hsetlik/PhaserPedal/PhaserPedalBoard/PhaserPedalBoard.kicad_pcb

## KiCad design PhaserPedalBoard/PhaserPedalBoard.kicad_pcb (2026-10-17)

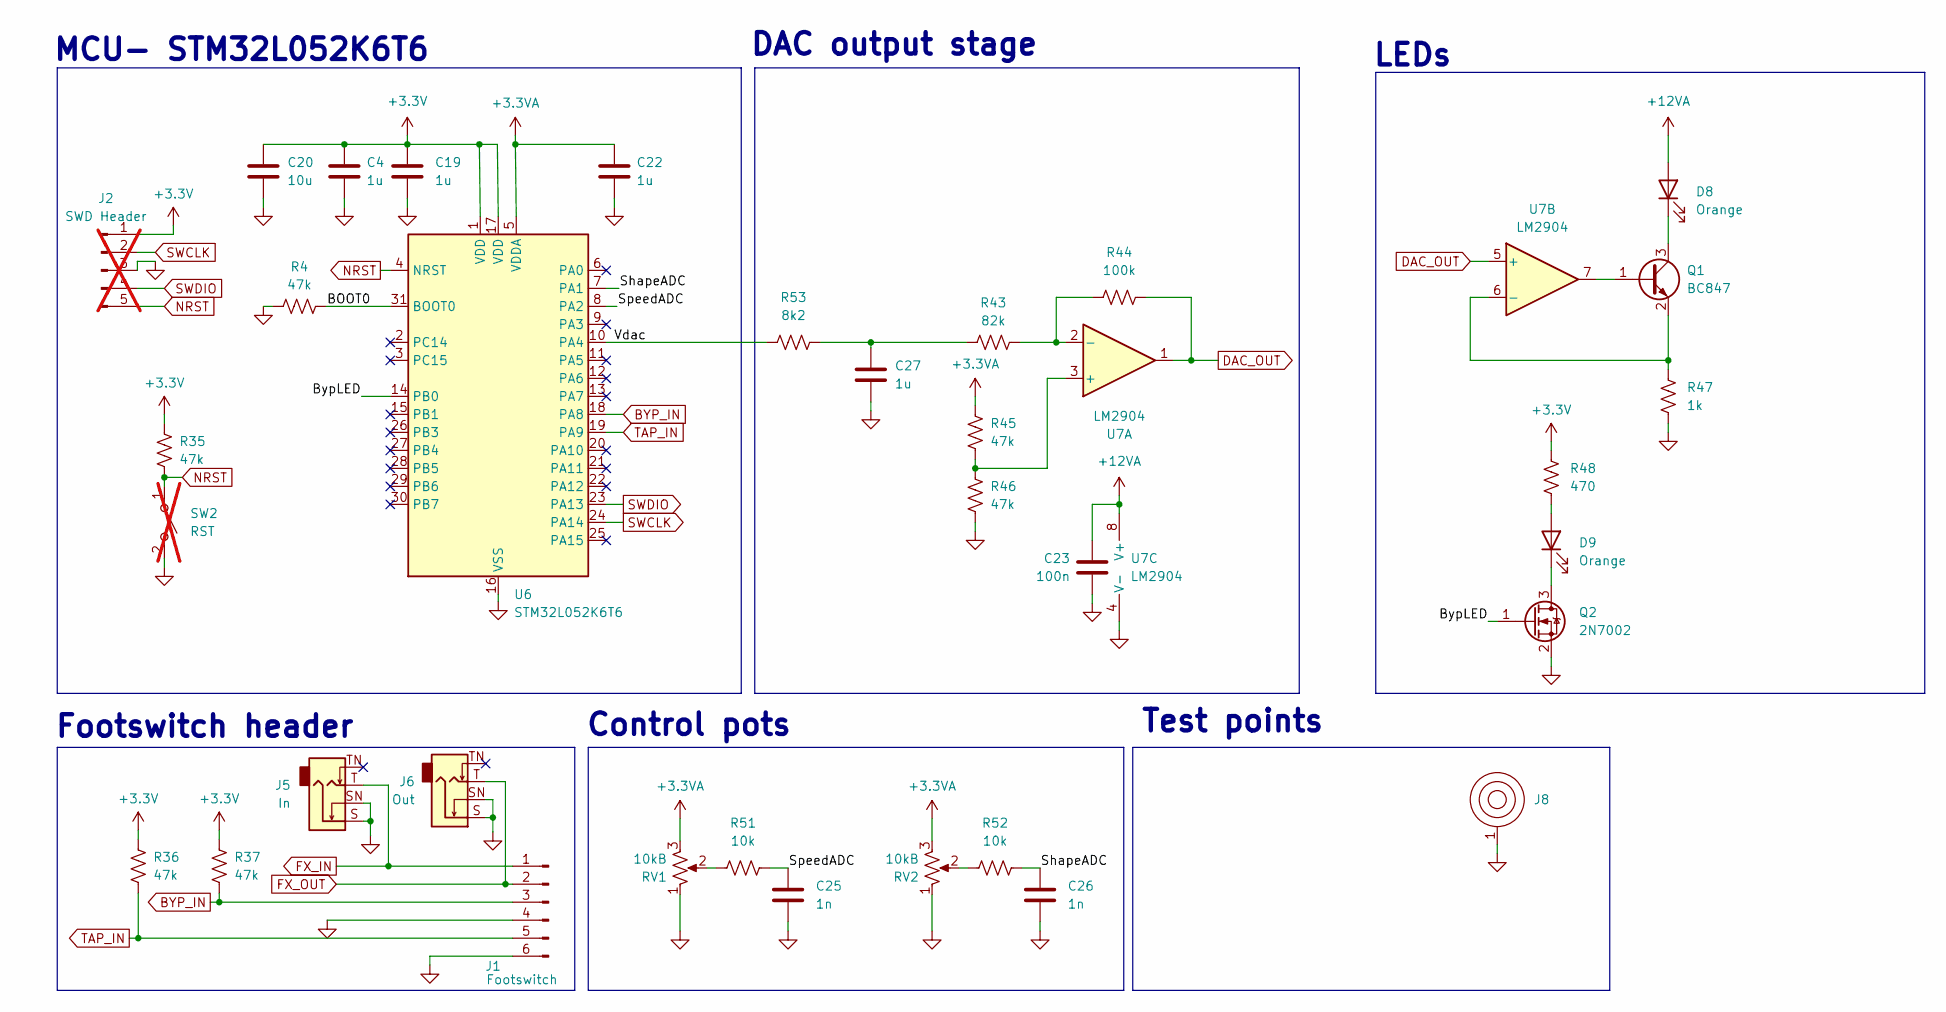
[picture p6: schematic Digital.kicad_sch]

Parts:
C4, C19, C22, C27: 1u; C_0805_2012Metric
C20: 10u; C_0805_2012Metric
C23: 100n; C_0805_2012Metric
C25, C26: 1n; C_0805_2012Metric
D8, D9: Orange; LED_D3.0mm; MPN LTL-4291N
J1: Footswitch; PinHeader_1x06_P2.54mm_Vertical
J2: SWD Header; PinHeader_1x05_P2.54mm_Vertical; not fitted
J5: In; Jack_6.35mm_Tayda_PJ664C_Mono_Horizontal; MPN PJ-644C MONO
J6: Out; Jack_6.35mm_Tayda_PJ664C_Mono_Horizontal; MPN PJ-644C MONO
J8: BatteryContact_Keystone_243
Q1: BC847; SOT-23
Q2: 2N7002; SOT-23; MPN 2N7002NXAKR
R4, R45, R46: 47k; R_0805_2012Metric
R35, R36, R37: 47k; R_0805_2012Metric; MPN RK73B2ATTE473J
R43: 82k; R_0805_2012Metric
R44: 100k; R_0805_2012Metric
R47: 1k; R_0805_2012Metric
R48: 470; R_0805_2012Metric; MPN RC0805JR-10470RL
R51, R52: 10k; R_0805_2012Metric
R53: 8k2; R_0805_2012Metric
RV1, RV2: 10kB; Potentiometer_Alpha_RV16AF_42_Single_Long; MPN RV9022NO-PA30B7.0-B10K-000-W3.0
SW2: RST; SW_SPST_B3U-1000P; not fitted
U6: STM32L052K6T6; LQFP-32_7x7mm_P0.8mm
U7: LM2904; SOIC-8_3.9x4.9mm_P1.27mm

Connections:
+3.3V: C4.1, C19.1, C20.1, J2.1, R35.1, R36.1, R37.1, R48.1, U6.1 (VDD), U6.17 (VDD); also elsewhere on the board
+3.3VA: C22.1, R45.2, RV1.3, RV2.3, U6.5 (VDDA); also elsewhere on the board
+12VA: C23.1, D8.2 (A), U7.8 (V+); also elsewhere on the board
/Digital/BOOT0: R4.2, U6.31 (BOOT0)
/Digital/BypLED: Q2.1 (G), U6.14 (PB0)
/Digital/ShapeADC: C26.1, R52.2, U6.7 (PA1)
/Digital/SpeedADC: C25.1, R51.2, U6.8 (PA2)
/Digital/Vdac: R53.1, U6.10 (PA4)
BYP_IN: J1.3, R37.2, U6.18 (PA8)
DAC_OUT: R44.2, U7.1, U7.5 (+); also elsewhere on the board
FX_IN: J1.1, J5.T; also elsewhere on the board
FX_OUT: J1.2, J6.T; also elsewhere on the board
GND: C4.2, C19.2, C20.2, C22.2, C23.2, C25.2, C26.2, C27.2, J1.4, J1.6, J2.3, J5.S, J5.SN, J6.S, J6.SN, J8.1, Q2.2 (S), R4.1, R46.1, R47.1, RV1.1, RV2.1, SW2.2 (B), U6.16 (VSS), U6.32 (VSS), U7.4 (V-); also elsewhere on the board
NRST: J2.5, R35.2, SW2.1 (A), U6.4 (NRST)
unnamed: C27.1, R43.1, R53.2
unnamed: D8.1 (K), Q1.3 (C)
unnamed: D9.2 (A), R48.2
unnamed: D9.1 (K), Q2.3 (D)
unnamed: Q1.1 (B), U7.7
unnamed: Q1.2 (E), R47.2, U7.6 (-)
unnamed: R51.1, RV1.2
unnamed: R52.1, RV2.2
unnamed: R45.1, R46.2, U7.3 (+)
unnamed: R43.2, R44.1, U7.2 (-)
SWCLK: J2.2, U6.24 (PA14)
SWDIO: J2.4, U6.23 (PA13)
TAP_IN: J1.5, R36.2, U6.19 (PA9)

Notes on the sheet:
Test points
MCU- STM32L052K6T6
LEDs
Footswitch header
Control pots
DAC output stage

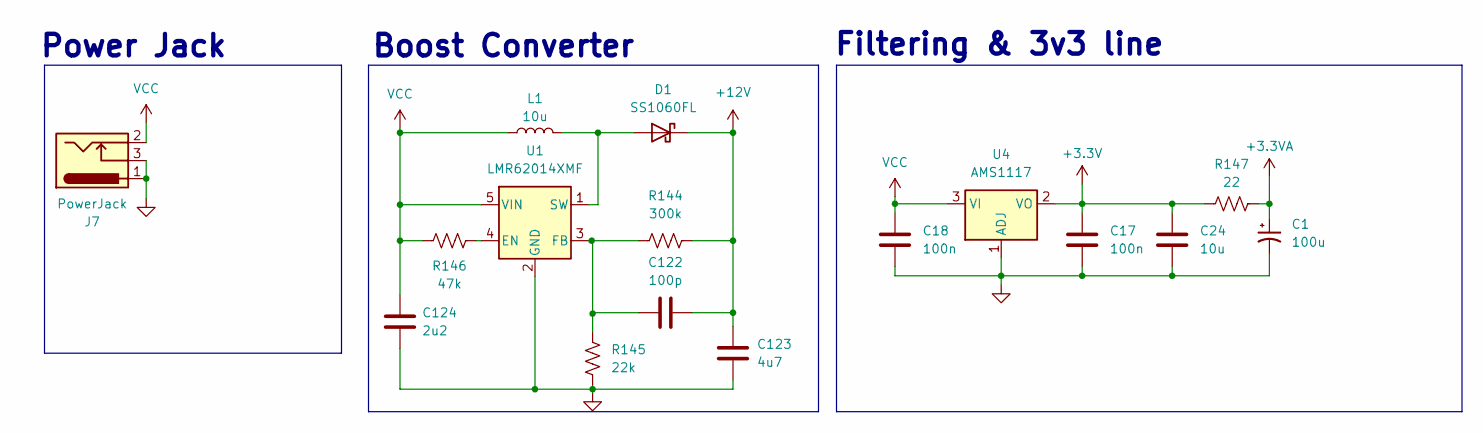
[picture p7: schematic Power.kicad_sch]

Parts:
C1: 100u; CP_Radial_D6.3mm_P2.50mm
C17, C18: 100n; C_0805_2012Metric; MPN KGF21BR71H104KT
C24: 10u; C_0805_2012Metric; MPN KGM21AR50J106KU
C122: 100p; C_0805_2012Metric
C123: 4u7; C_0805_2012Metric
C124: 2u2; C_0805_2012Metric
D1: SS1060FL; D_SOD-123F
J7: PowerJack; BarrelJack_Horizontal; MPN NEB 21 R-C
L1: 10u; L_SigTransformer_SLPPI04_15
R144: 300k; R_0805_2012Metric
R145: 22k; R_0805_2012Metric
R146: 47k; R_0805_2012Metric
R147: 22; R_0805_2012Metric
U1: LMR62014XMF; SOT-23-5
U4: AMS1117; SOT-223-3_TabPin2; MPN LD1117S33CTR

Connections:
+3.3V: C17.2, C24.2, R147.2, U4.2 (VO); also elsewhere on the board
+3.3VA: C1.1, R147.1; also elsewhere on the board
+12V: C122.2, C123.1, D1.1 (K), R144.2; also elsewhere on the board
GND: C1.2, C17.1, C18.1, C24.1, C123.2, C124.2, J7.1, J7.3, R145.1, U1.2 (GND), U4.1 (ADJ); also elsewhere on the board
unnamed: D1.2 (A), L1.2, U1.1 (SW)
unnamed: R146.2, U1.4 (EN)
unnamed: C122.1, R144.1, R145.2, U1.3 (FB)
VCC: C18.2, C124.1, J7.2, L1.1, R146.1, U1.5 (VIN), U4.3 (VI)

Notes on the sheet:
Power Jack
Filtering & 3v3 line
Boost Converter

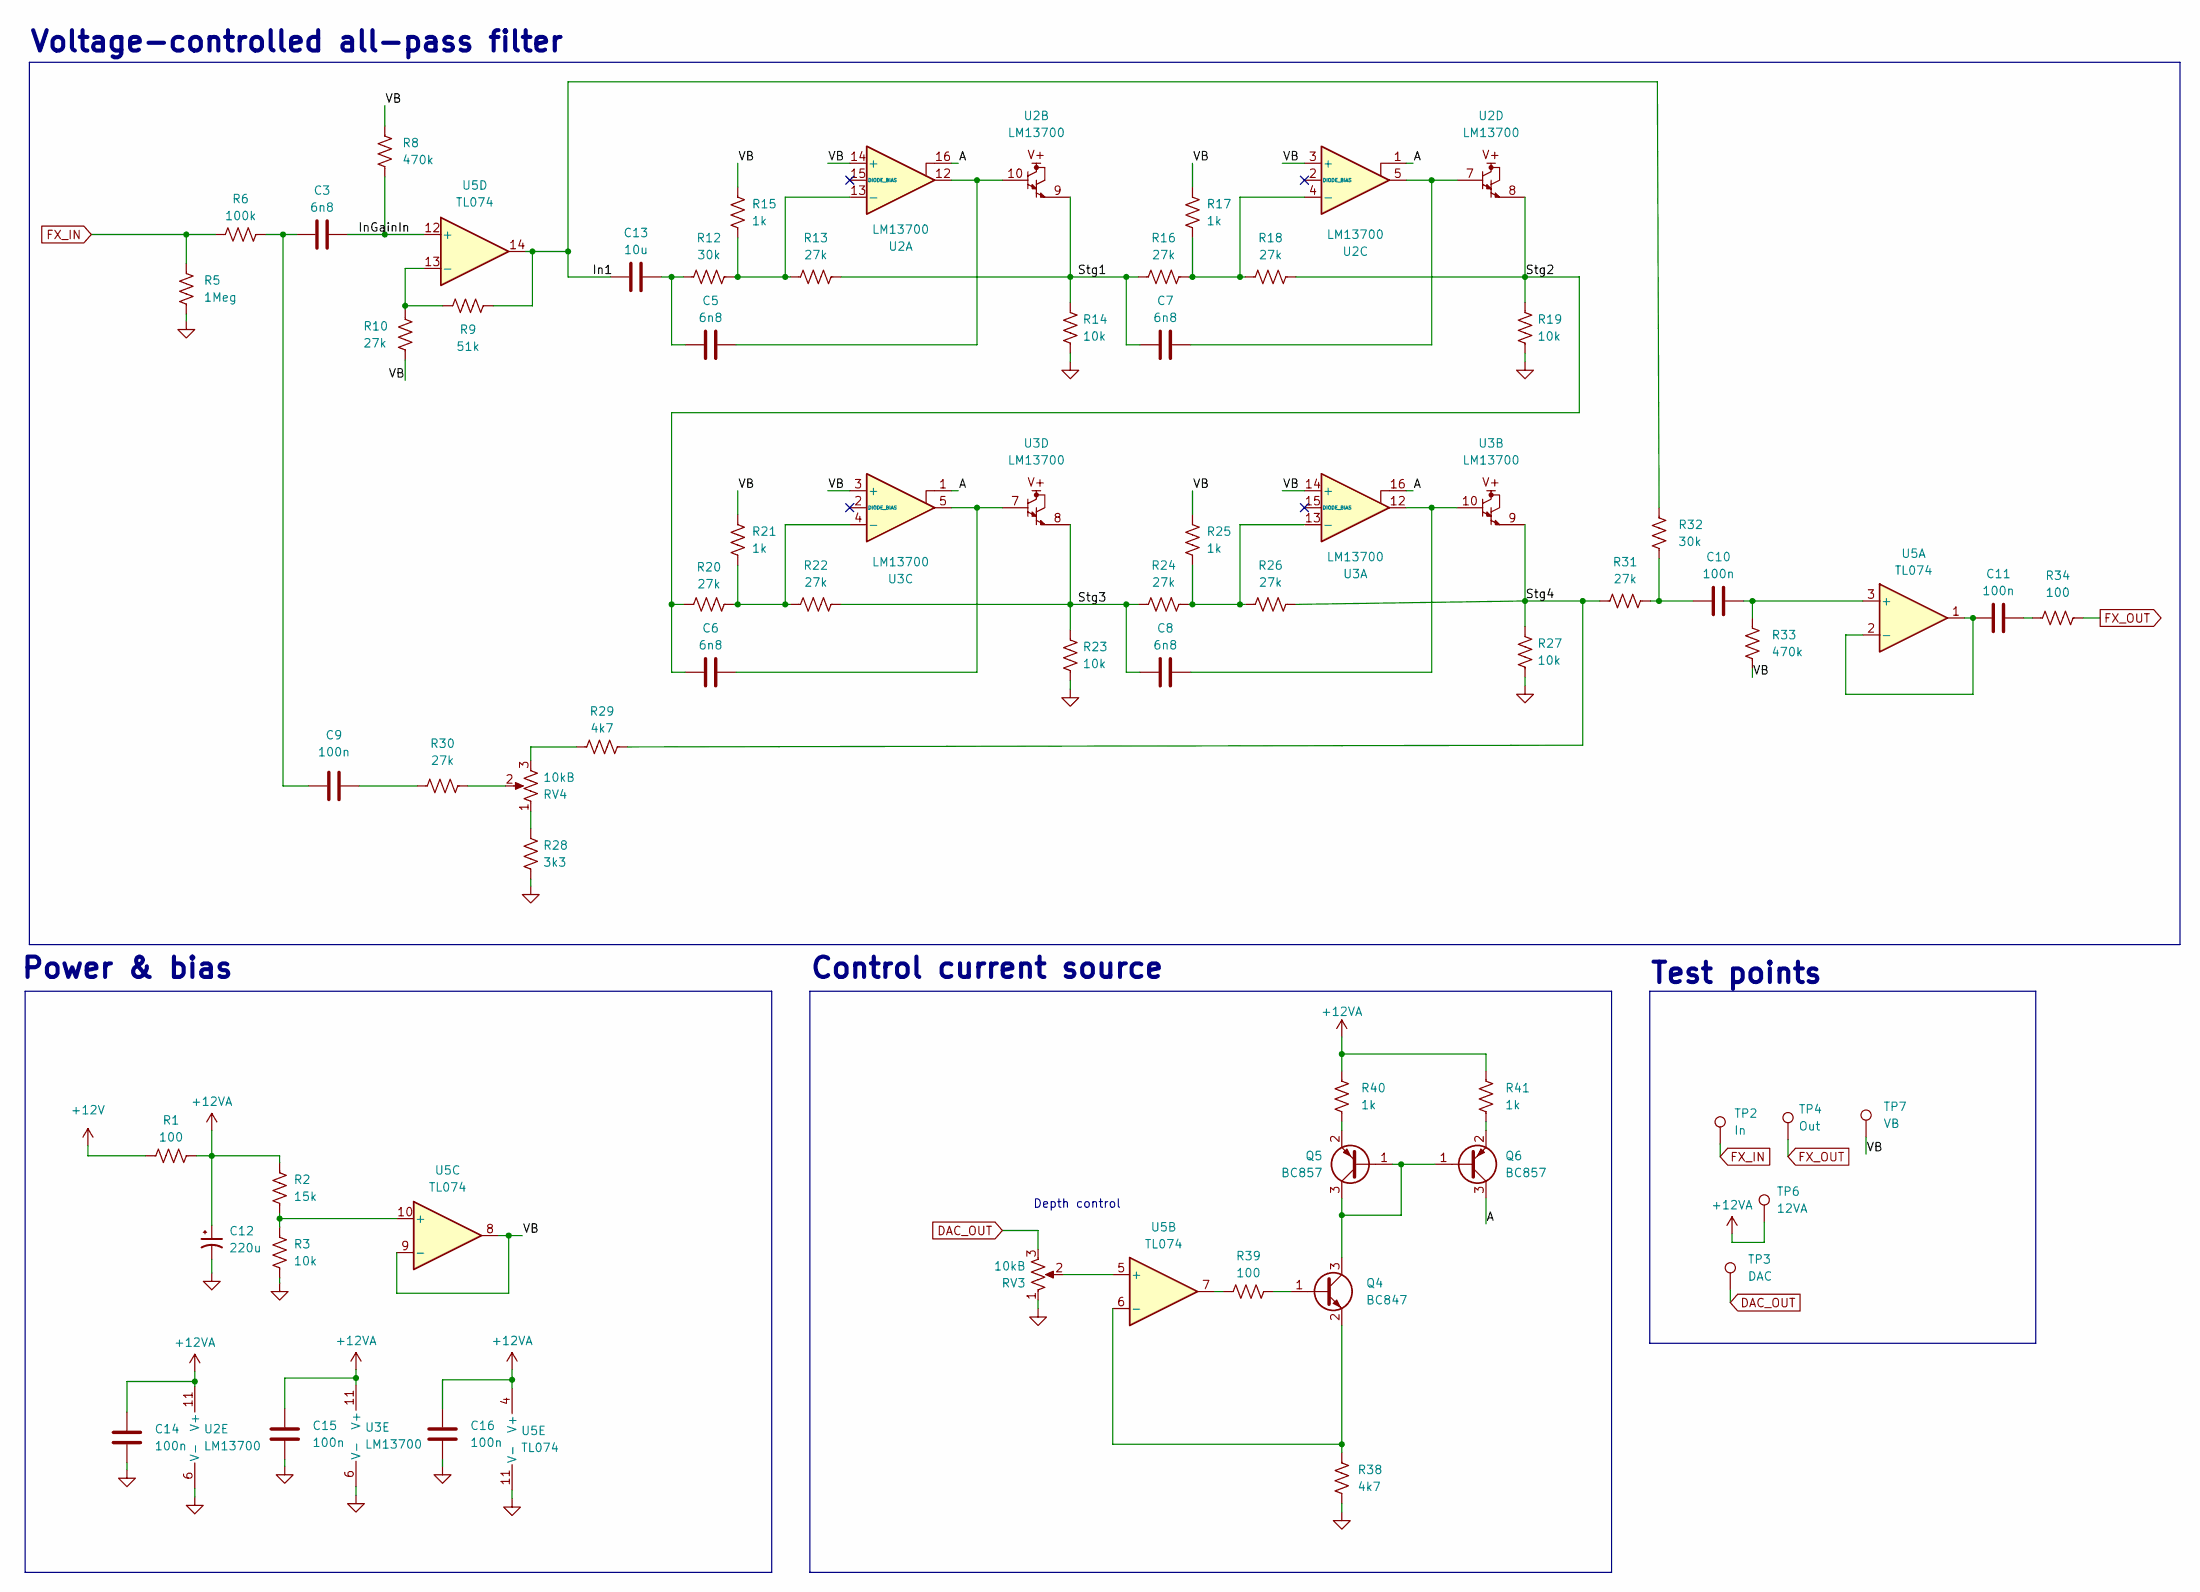
[picture p8: schematic Analog.kicad_sch]

Parts:
C3, C5, C6, C7, C8: 6n8; C_0805_2012Metric
C9, C10, C11, C14, C15, C16: 100n; C_0805_2012Metric
C12: 220u; CP_Radial_D7.5mm_P2.50mm
C13: 10u; C_0805_2012Metric
Q4: BC847; SOT-23
Q5, Q6: BC857; SOT-23
R1, R34, R39: 100; R_0805_2012Metric
R2: 15k; R_0805_2012Metric
R3, R14, R19, R23, R27: 10k; R_0805_2012Metric
R5: 1Meg; R_0805_2012Metric
R6: 100k; R_0805_2012Metric
R8, R33: 470k; R_0805_2012Metric
R9: 51k; R_0805_2012Metric
R10, R13, R16, R18, R20, R22, R24, R26, R30, R31: 27k; R_0805_2012Metric
R12, R32: 30k; R_0805_2012Metric
R15, R17, R21, R25, R40, R41: 1k; R_0805_2012Metric
R28: 3k3; R_0805_2012Metric
R29, R38: 4k7; R_0805_2012Metric
RV3, RV4: 10kB; Potentiometer_Alpha_RV16AF_42_Single_Long; MPN RV9022NO-PA30B7.0-B10K-000-W3.0
TP2: In; TestPoint_THTPad_D2.0mm_Drill1.0mm_VAL
TP3: DAC; TestPoint_THTPad_D2.0mm_Drill1.0mm_VAL
TP4: Out; TestPoint_THTPad_D2.0mm_Drill1.0mm_VAL
TP6: 12VA; TestPoint_THTPad_D2.0mm_Drill1.0mm_VAL
TP7: VB; TestPoint_THTPad_D2.0mm_Drill1.0mm_VAL
U2, U3: LM13700; SOIC-16_3.9x9.9mm_P1.27mm
U5: TL074; SOIC-14_3.9x8.7mm_P1.27mm

Connections:
+12V: R1.1; also elsewhere on the board
+12VA: C12.1, C14.2, C15.2, C16.2, R1.2, R2.2, R40.2, R41.2, TP6.1 (1_1), U2.11 (V+), U3.11 (V+), U5.4 (V+); also elsewhere on the board
/Analog/A: Q6.3 (C), U2.1, U2.16, U3.1, U3.16
/Analog/In1: C13.1, R9.1, R32.1, U5.14
/Analog/InGainIn: C3.2, R8.1, U5.12 (+)
/Analog/Stg1: C7.1, R13.1, R14.1, R16.2, U2.9
/Analog/Stg2: C6.1, R18.1, R19.1, R20.2, U2.8
/Analog/Stg3: C8.1, R22.1, R23.1, R24.2, U3.8
/Analog/Stg4: R26.1, R27.1, R29.2, R31.2, U3.9
/Analog/VB: R8.2, R10.2, R15.1, R17.1, R21.1, R25.1, R33.2, TP7.1 (1_1), U2.3 (+), U2.14 (+), U3.3 (+), U3.14 (+), U5.8, U5.9 (-)
DAC_OUT: RV3.3, TP3.1 (1_1); also elsewhere on the board
FX_IN: R5.2, R6.1, TP2.1 (1_1); also elsewhere on the board
FX_OUT: R34.1, TP4.1 (1_1); also elsewhere on the board
GND: C12.2, C14.1, C15.1, C16.1, R3.1, R5.1, R14.2, R19.2, R23.2, R27.2, R28.1, R38.1, RV3.1, U2.6 (V-), U3.6 (V-), U5.11 (V-); also elsewhere on the board
unnamed: C3.1, C9.1, R6.2
unnamed: C5.2, U2.10, U2.12
unnamed: C6.2, U3.5, U3.7
unnamed: C7.2, U2.5, U2.7
unnamed: C8.2, U3.10, U3.12
unnamed: C9.2, R30.1
unnamed: C10.1, R31.1, R32.2
unnamed: C11.2, R34.2
unnamed: C5.1, C13.2, R12.2
unnamed: Q4.1 (B), R39.2
unnamed: Q4.3 (C), Q5.1 (B), Q5.3 (C), Q6.1 (B)
unnamed: Q4.2 (E), R38.2, U5.6 (-)
unnamed: Q5.2 (E), R40.1
unnamed: Q6.2 (E), R41.1
unnamed: R28.2, RV4.1
unnamed: R29.1, RV4.3
unnamed: R30.2, RV4.2
unnamed: R39.1, U5.7
unnamed: R12.1, R13.2, R15.2, U2.13 (-)
unnamed: R16.1, R17.2, R18.2, U2.4 (-)
unnamed: R24.1, R25.2, R26.2, U3.13 (-)
unnamed: R20.1, R21.2, R22.2, U3.4 (-)
unnamed: C10.2, R33.1, U5.3 (+)
unnamed: C11.1, U5.1, U5.2 (-)
unnamed: RV3.2, U5.5 (+)
unnamed: R2.1, R3.2, U5.10 (+)
unnamed: R9.2, R10.1, U5.13 (-)

Notes on the sheet:
Control current source
Test points
Voltage-controlled all-pass filter
Depth control
Power & bias

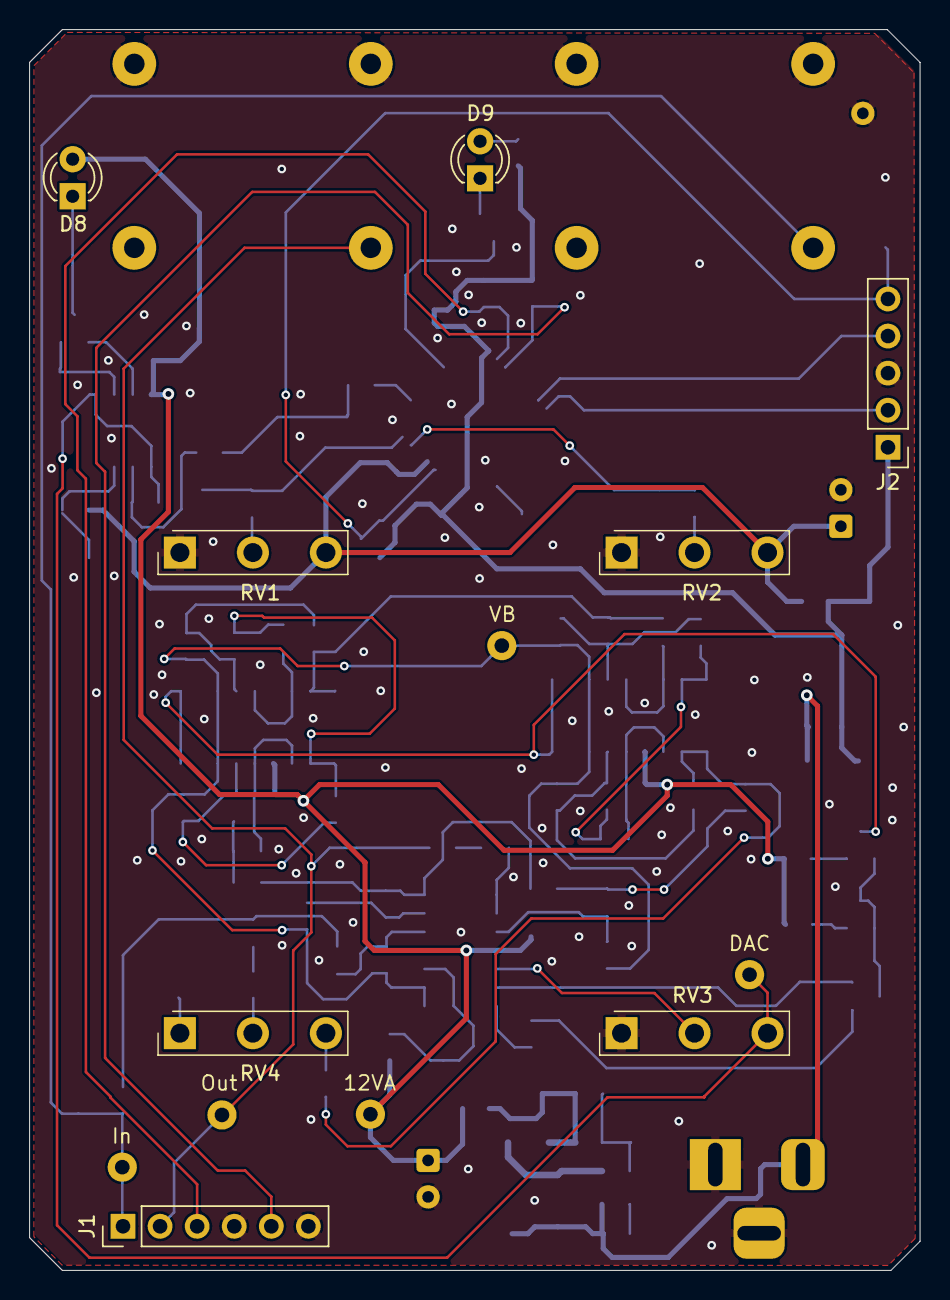
[picture p9: board PhaserPedalBoard.kicad_pcb from above]

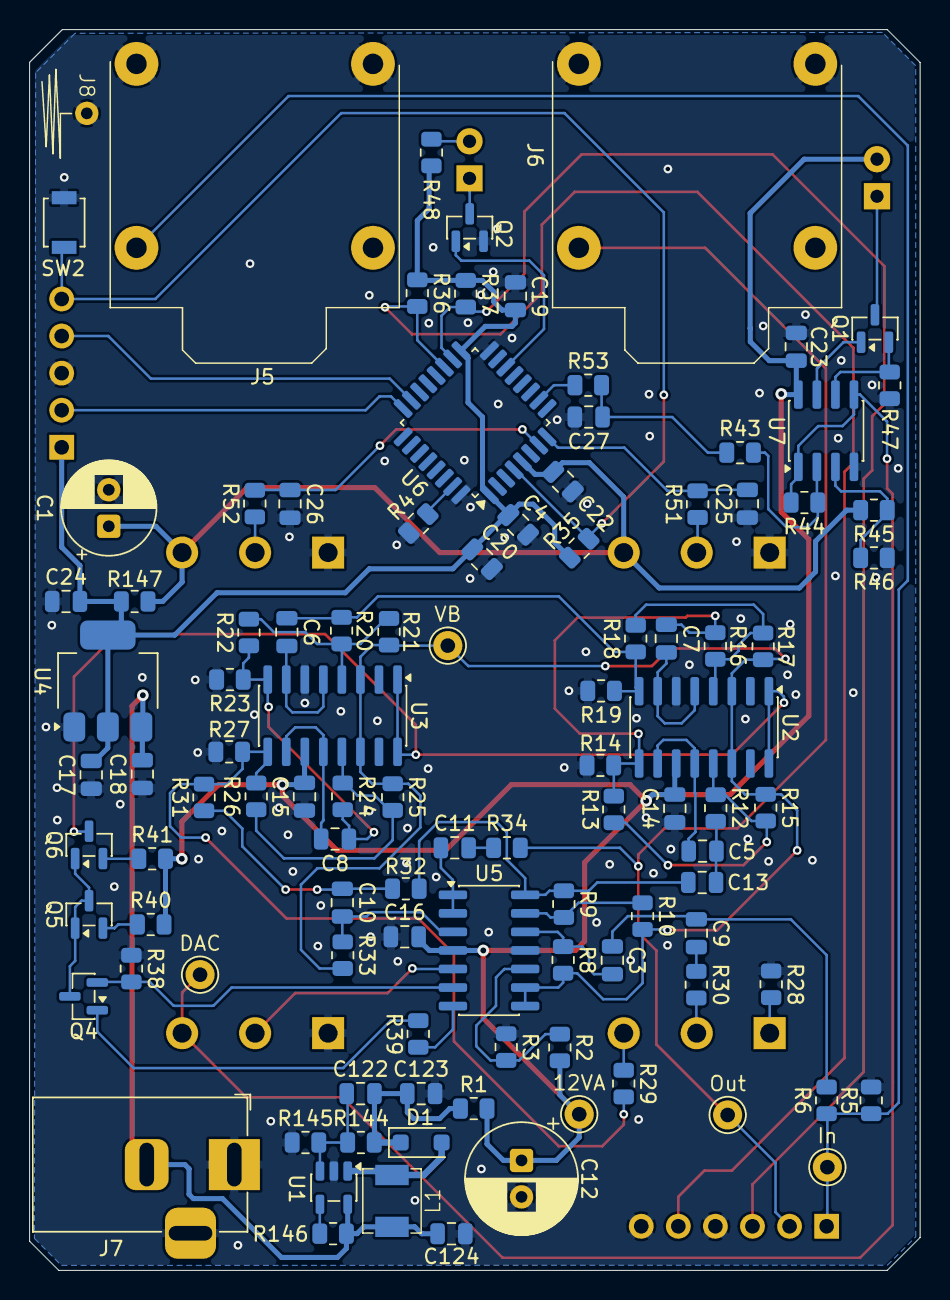
[picture p10: board PhaserPedalBoard.kicad_pcb from below]

Board: 4 copper layers, 61.0 x 85.0 mm, 112 parts (104 on the bottom side), 67 nets.
