hsetlik/PhaserPedal/Simulations/AnalogSim/AnalogSim.kicad_sch

## KiCad design Simulations/AnalogSim/AnalogSim.kicad_sch (2026-10-16)

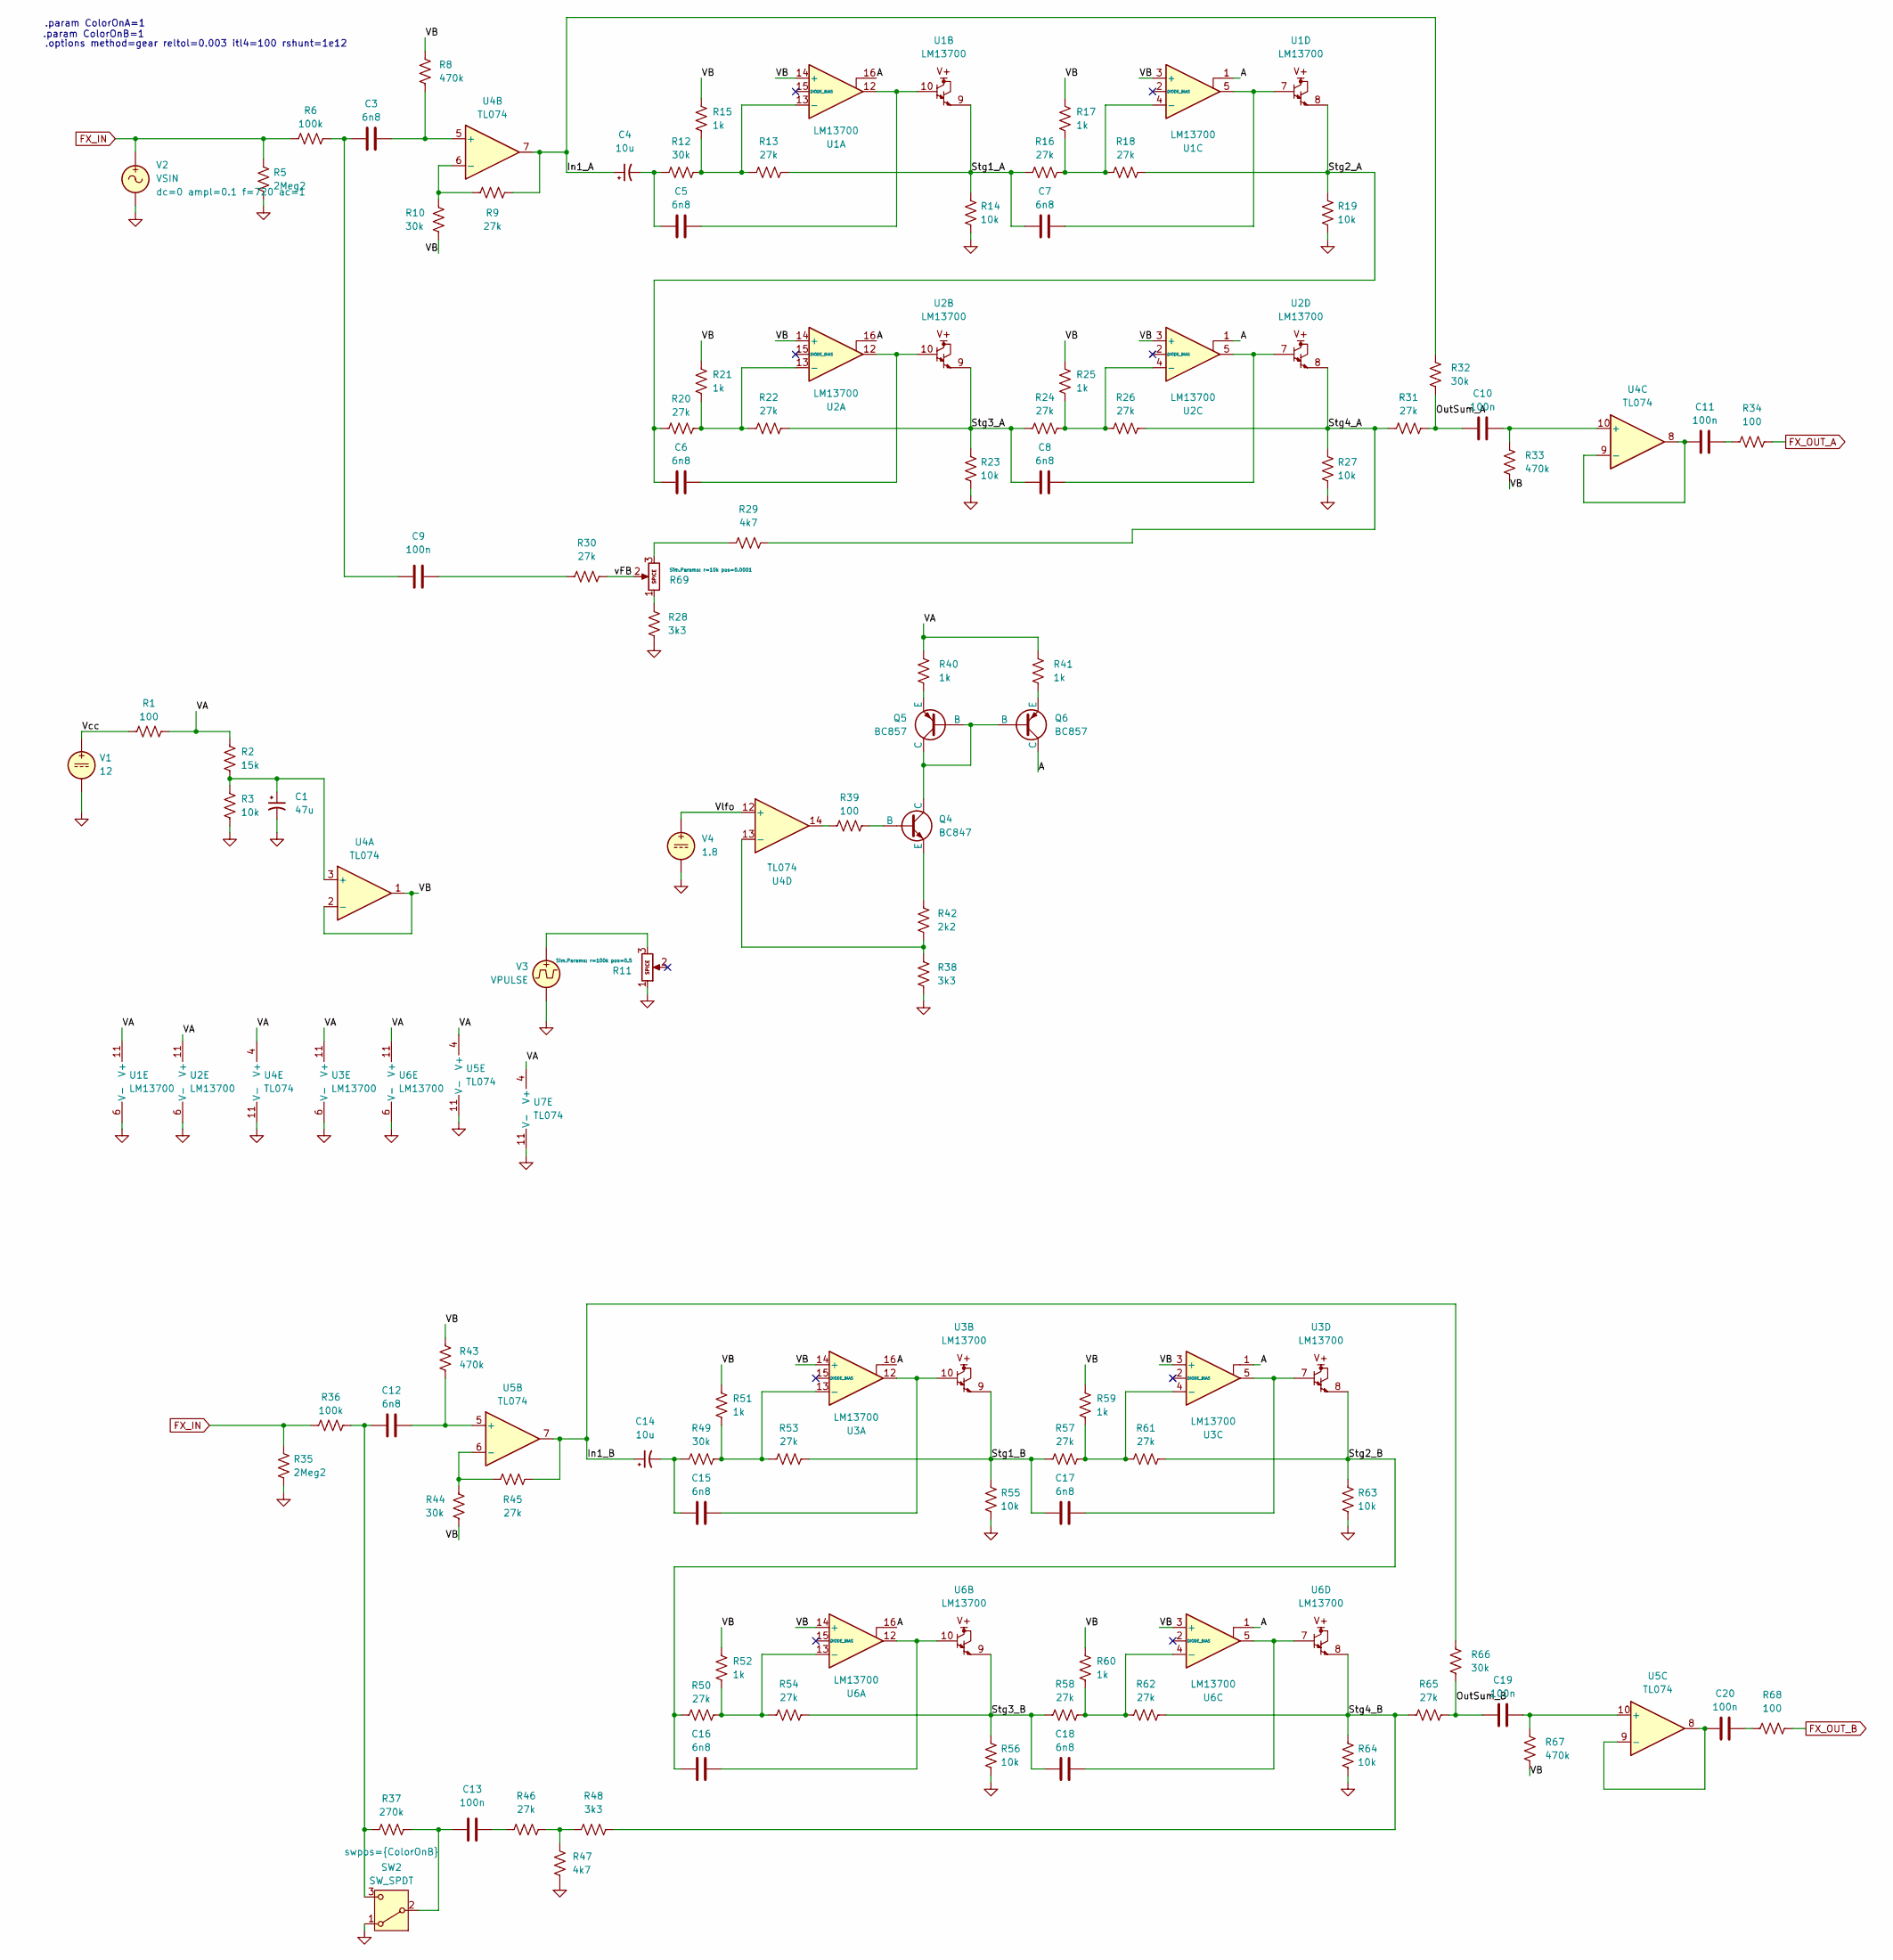
[picture p11: schematic AnalogSim.kicad_sch]

Parts:
C1: 47u
C3, C5, C6, C7, C8, C12, C15, C16, C17, C18: 6n8
C4, C14: 10u
C9, C10, C11, C13, C19, C20: 100n
Q4: BC847
Q5, Q6: BC857
R1, R34, R39, R68: 100
R2: 15k
R3, R14, R19, R23, R27, R55, R56, R63, R64: 10k
R5, R35: 2Meg2
R6, R36: 100k
R8, R33, R43, R67: 470k
R9, R13, R16, R18, R20, R22, R24, R26, R30, R31, R45, R46, R50, R53, R54, R57, R58, R61, R62, R65: 27k
R10, R12, R32, R44, R49, R66: 30k
R11, R69: Potentiometer
R15, R17, R21, R25, R40, R41, R51, R52, R59, R60: 1k
R28, R38, R48: 3k3
R29, R47: 4k7
R37: 270k
R42: 2k2
SW2: SW_SPDT; SW_SPDT_Dailywell_Mini_1M
U1, U2, U3, U6: LM13700
U4, U5, U7: TL074; SOIC-14_3.9x8.7mm_P1.27mm
V1: 12
V2: VSIN
V3: VPULSE
V4: 1.8

Connections:
A: Q6.1 (C), U1.1, U1.16, U2.1, U2.16, U3.1, U3.16, U6.1, U6.16
FX_IN: R5.2, R6.1, R35.2, R36.1, V2.1
FX_OUT_A: R34.1
FX_OUT_B: R68.1
GND: C1.2, R3.1, R5.1, R11.1, R14.2, R19.2, R23.2, R27.2, R28.1, R35.1, R38.1, R47.1, R55.2, R56.2, R63.2, R64.2, SW2.1 (A), U1.6 (V-), U2.6 (V-), U3.6 (V-), U4.11 (V-), U5.11 (V-), U6.6 (V-), U7.11 (V-), V1.2, V2.2, V3.2, V4.2
In1_A: C4.1, R9.1, R32.1, U4.7
In1_B: C14.1, R45.1, R66.1, U5.7
unnamed: C1.1, R2.1, R3.2, U4.3 (+)
unnamed: C3.1, C9.1, R6.2
unnamed: C3.2, R8.1, U4.5 (+)
unnamed: C4.2, C5.1, R12.2
unnamed: C5.2, U1.10, U1.12
unnamed: C6.2, U2.10, U2.12
unnamed: C7.2, U1.5, U1.7
unnamed: C8.2, U2.5, U2.7
unnamed: C9.2, R30.1
unnamed: C10.2, R33.1, U4.10 (+)
unnamed: C11.1, U4.8, U4.9 (-)
unnamed: C11.2, R34.2
unnamed: C12.1, R36.2, R37.2, SW2.3 (C)
unnamed: C12.2, R43.1, U5.5 (+)
unnamed: C13.1, R37.1, SW2.2 (B)
unnamed: C13.2, R46.1
unnamed: C14.2, C15.1, R49.2
unnamed: C15.2, U3.10, U3.12
unnamed: C16.2, U6.10, U6.12
unnamed: C17.2, U3.5, U3.7
unnamed: C18.2, U6.5, U6.7
unnamed: C19.2, R67.1, U5.10 (+)
unnamed: C20.1, U5.8, U5.9 (-)
unnamed: C20.2, R68.2
unnamed: Q4.1 (C), Q5.1 (C), Q5.2 (B), Q6.2 (B)
unnamed: Q4.2 (B), R39.2
unnamed: Q4.3 (E), R42.2
unnamed: Q5.3 (E), R40.1
unnamed: Q6.3 (E), R41.1
unnamed: R9.2, R10.1, U4.6 (-)
unnamed: R11.3, V3.1
unnamed: R12.1, R13.2, R15.2, U1.13 (-)
unnamed: R16.1, R17.2, R18.2, U1.4 (-)
unnamed: R20.1, R21.2, R22.2, U2.13 (-)
unnamed: R24.1, R25.2, R26.2, U2.4 (-)
unnamed: R28.2, R69.1
unnamed: R29.1, R69.3
unnamed: R38.2, R42.1, U4.13 (-)
unnamed: R39.1, U4.14
unnamed: R44.1, R45.2, U5.6 (-)
unnamed: R46.2, R47.2, R48.1
unnamed: R49.1, R51.2, R53.2, U3.13 (-)
unnamed: R50.1, R52.2, R54.2, U6.13 (-)
unnamed: R57.1, R59.2, R61.2, U3.4 (-)
unnamed: R58.1, R60.2, R62.2, U6.4 (-)
OutSum_A: C10.1, R31.1, R32.2
OutSum_B: C19.1, R65.1, R66.2
Stg1_A: C7.1, R13.1, R14.1, R16.2, U1.9
Stg1_B: C17.1, R53.1, R55.1, R57.2, U3.9
Stg2_A: C6.1, R18.1, R19.1, R20.2, U1.8
Stg2_B: C16.1, R50.2, R61.1, R63.1, U3.8
Stg3_A: C8.1, R22.1, R23.1, R24.2, U2.9
Stg3_B: C18.1, R54.1, R56.1, R58.2, U6.9
Stg4_A: R26.1, R27.1, R29.2, R31.2, U2.8
Stg4_B: R48.2, R62.1, R64.1, R65.2, U6.8
VA: R1.2, R2.2, R40.2, R41.2, U1.11 (V+), U2.11 (V+), U3.11 (V+), U4.4 (V+), U5.4 (V+), U6.11 (V+), U7.4 (V+)
VB: R8.2, R10.2, R15.1, R17.1, R21.1, R25.1, R33.2, R43.2, R44.2, R51.1, R52.1, R59.1, R60.1, R67.2, U1.3 (+), U1.14 (+), U2.3 (+), U2.14 (+), U3.3 (+), U3.14 (+), U4.1, U4.2 (-), U6.3 (+), U6.14 (+)
Vcc: R1.1, V1.1
Vlfo: U4.12 (+), V4.1
vFB: R30.2, R69.2

Notes on the sheet:
.options method=gear reltol=0.003 itl4=100 rshunt=1e12
.param ColorOnA=1
.param ColorOnB=1
