hsetlik/PhaserPedal/Simulations/OutputStageSim/OutputStageSim.kicad_sch

## KiCad design Simulations/OutputStageSim/OutputStageSim.kicad_sch (2026-10-12)

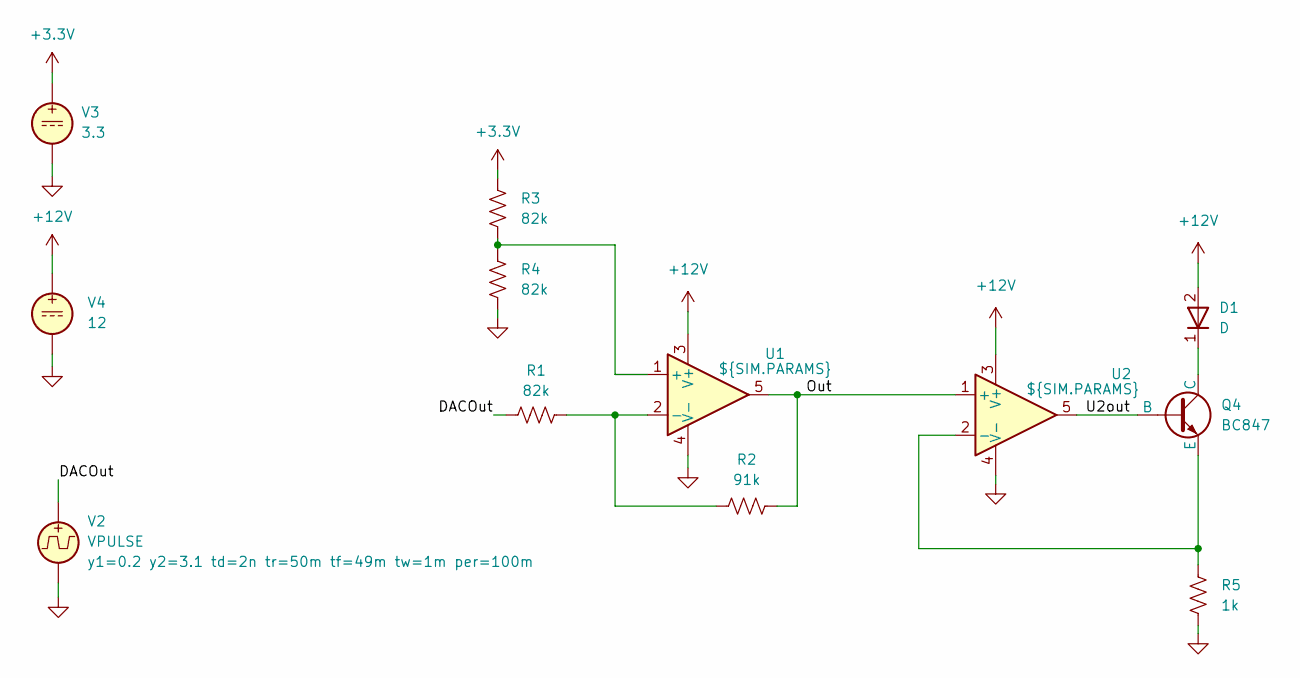
[picture p12: schematic OutputStageSim.kicad_sch]

Parts:
D1: D
Q4: BC847
R1, R3, R4: 82k
R2: 91k
R5: 1k
U1, U2: ${SIM.PARAMS}
V2: VPULSE
V3: 3.3
V4: 12

Connections:
+3.3V: R3.2, V3.1
+12V: D1.2 (A), U1.3 (V+), U2.3 (V+), V4.1
DACOut: R1.1, V2.1
GND: R4.1, R5.1, U1.4 (V-), U2.4 (V-), V2.2, V3.2, V4.2
unnamed: D1.1 (K), Q4.1 (C)
unnamed: Q4.3 (E), R5.2, U2.2 (-)
unnamed: R1.2, R2.1, U1.2 (-)
unnamed: R3.1, R4.2, U1.1 (+)
Out: R2.2, U1.5, U2.1 (+)
U2out: Q4.2 (B), U2.5
