hsetlik/PhaserPedal/Simulations/SmallStoneSim/SmallStoneSim.kicad_sch

## KiCad design Simulations/SmallStoneSim/SmallStoneSim.kicad_sch (2026-10-11)

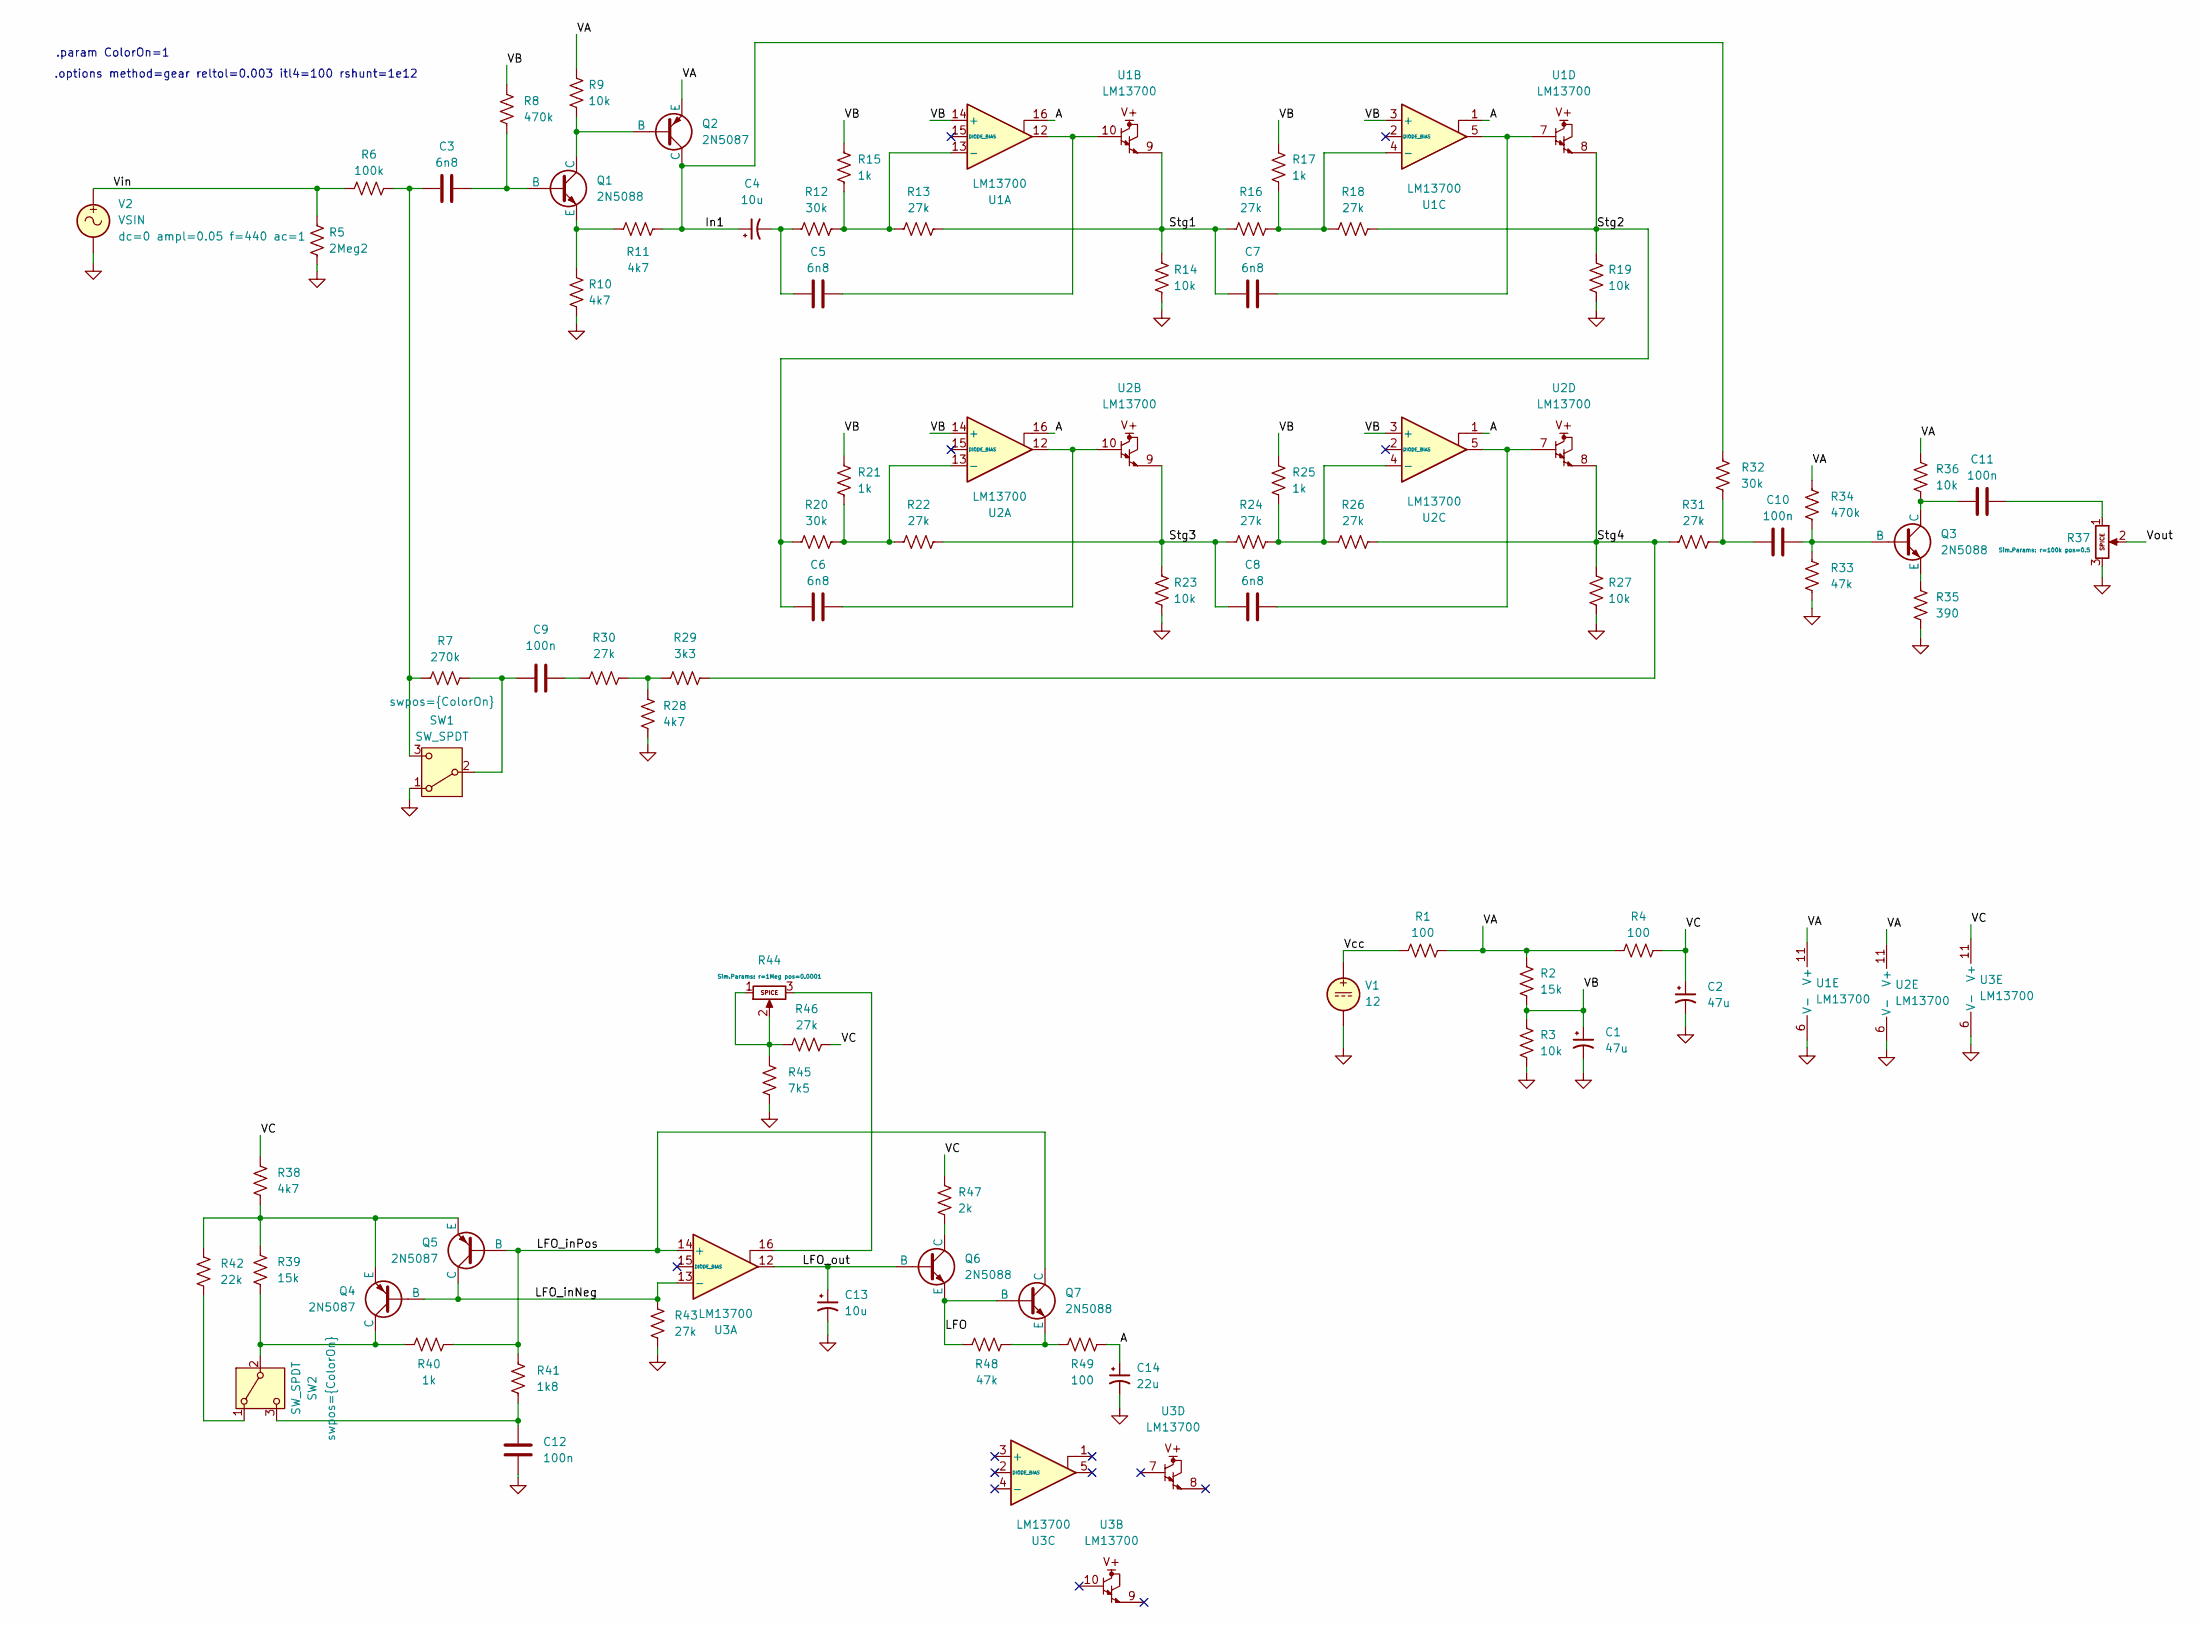
[picture p13: schematic SmallStoneSim.kicad_sch]

Parts:
C1, C2: 47u
C3, C5, C6, C7, C8: 6n8
C4, C13: 10u
C9, C10, C11, C12: 100n
C14: 22u
Q1, Q3, Q6, Q7: 2N5088
Q2, Q4, Q5: 2N5087
R1, R4, R49: 100
R2, R39: 15k
R3, R9, R14, R19, R23, R27, R36: 10k
R5: 2Meg2
R6: 100k
R7: 270k
R8, R34: 470k
R10, R11, R28, R38: 4k7
R12, R20, R32: 30k
R13, R16, R18, R22, R24, R26, R30, R31, R43, R46: 27k
R15, R17, R21, R25, R40: 1k
R29: 3k3
R33, R48: 47k
R35: 390
R37, R44: Potentiometer
R41: 1k8
R42: 22k
R45: 7k5
R47: 2k
SW1, SW2: SW_SPDT; SW_SPDT_Dailywell_Mini_1M
U1, U2, U3: LM13700
V1: 12
V2: VSIN

Connections:
A: C14.1, R49.2, U1.1, U1.16, U2.1, U2.16
GND: C1.2, C2.2, C12.1, C13.2, C14.2, R3.1, R5.1, R10.1, R14.2, R19.2, R23.2, R27.2, R28.1, R33.2, R35.2, R37.3, R43.1, R45.1, SW1.1 (A), U1.6 (V-), U2.6 (V-), U3.6 (V-), V1.2, V2.2
In1: C4.1, Q2.1 (C), R11.1, R32.1
LFO: Q6.3 (E), Q7.2 (B), R48.1
LFO_inNeg: Q4.2 (B), Q5.1 (C), R43.2, U3.13 (-)
LFO_inPos: Q5.2 (B), Q7.1 (C), R40.2, R41.2, U3.14 (+)
LFO_out: C13.1, Q6.2 (B), U3.12
unnamed: C3.1, R6.2, R7.2, SW1.3 (C)
unnamed: C3.2, Q1.2 (B), R8.1
unnamed: C4.2, C5.1, R12.2
unnamed: C5.2, U1.10, U1.12
unnamed: C6.2, U2.10, U2.12
unnamed: C7.2, U1.5, U1.7
unnamed: C8.2, U2.5, U2.7
unnamed: C9.1, R7.1, SW1.2 (B)
unnamed: C9.2, R30.1
unnamed: C10.1, R31.1, R32.2
unnamed: C10.2, Q3.2 (B), R33.1, R34.2
unnamed: C11.1, Q3.1 (C), R36.2
unnamed: C11.2, R37.1
unnamed: C12.2, R41.1, SW2.3 (C)
unnamed: Q1.1 (C), Q2.2 (B), R9.1
unnamed: Q1.3 (E), R10.2, R11.2
unnamed: Q3.3 (E), R35.1
unnamed: Q4.1 (C), R39.1, R40.1, SW2.2 (B)
unnamed: Q4.3 (E), Q5.3 (E), R38.1, R39.2, R42.2
unnamed: Q6.1 (C), R47.1
unnamed: Q7.3 (E), R48.2, R49.1
unnamed: R12.1, R13.2, R15.2, U1.13 (-)
unnamed: R16.1, R17.2, R18.2, U1.4 (-)
unnamed: R20.1, R21.2, R22.2, U2.13 (-)
unnamed: R24.1, R25.2, R26.2, U2.4 (-)
unnamed: R28.2, R29.1, R30.2
unnamed: R42.1, SW2.1 (A)
unnamed: R44.1, R44.2, R45.2, R46.1
unnamed: R44.3, U3.16
Stg1: C7.1, R13.1, R14.1, R16.2, U1.9
Stg2: C6.1, R18.1, R19.1, R20.2, U1.8
Stg3: C8.1, R22.1, R23.1, R24.2, U2.9
Stg4: R26.1, R27.1, R29.2, R31.2, U2.8
VA: Q2.3 (E), R1.2, R2.2, R4.1, R9.2, R34.1, R36.1, U1.11 (V+), U2.11 (V+)
VB: C1.1, R2.1, R3.2, R8.2, R15.1, R17.1, R21.1, R25.1, U1.3 (+), U1.14 (+), U2.3 (+), U2.14 (+)
VC: C2.1, R4.2, R38.2, R46.2, R47.2, U3.11 (V+)
Vcc: R1.1, V1.1
Vin: R5.2, R6.1, V2.1
Vout: R37.2

Notes on the sheet:
.param ColorOn=1
.options method=gear reltol=0.003 itl4=100 rshunt=1e12
