hsetlik/PhaserPedal/PhaserPedalFirmware/Core/Src/main.c

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
/* Includes ------------------------------------------------------------------*/
#include "main.h"

/* USER CODE BEGIN Includes */
#include "tap_tempo.h"
#include "lfo.h"
#include "norm_range.h"
/* USER CODE END Includes */

/* USER CODE BEGIN PD */
#define SPEED_MIN 0.15f
#define SPEED_MAX 10.0f
#define SPEED_CENTER 1.3f

#define SHAPE_MIN 0.03f
#define SHAPE_MAX 0.97f
#define SHAPE_CENTER 0.5f
/* USER CODE END PD */

ADC_HandleTypeDef hadc;

DAC_HandleTypeDef hdac;
DMA_HandleTypeDef hdma_dac_ch1;

TIM_HandleTypeDef htim2;
TIM_HandleTypeDef htim6;
TIM_HandleTypeDef htim21;

/* USER CODE BEGIN PV */
// main DMA buffer
uint16_t dmaBuf[DMA_BUF_SIZE * 2];
uint16_t* const dmaPtrA = dmaBuf;
uint16_t* const dmaPtrB = &dmaBuf[DMA_BUF_SIZE];
volatile bool bufferReady = false;
uint16_t* nextBuffer = dmaPtrA;
lfo_state lfo;
bool speedKnobMoved = false;
bool inTapMode = false;
// knob state
float currentSpeedValue = 0.0f;
float currentShapeValue = 0.0f;
// knob ranges
norm_range_t speedRange;
norm_range_t shapeRange;
// global time stuff
static const float secsIncrement = 1.0f / (float)TAP_SAMPLE_RATE;
static float globalSeconds = 0.0f;


/* USER CODE END PV */

void SystemClock_Config(void);
static void MX_GPIO_Init(void);
static void MX_DMA_Init(void);
static void MX_DAC_Init(void);
static void MX_ADC_Init(void);
static void MX_TIM2_Init(void);
static void MX_TIM6_Init(void);
static void MX_TIM21_Init(void);
/* USER CODE BEGIN PFP */
void readPotADCs();
void initControlRanges();
/* USER CODE END PFP */

/* USER CODE BEGIN 0 */
void fillNextBuffer(uint16_t* buf){
  for(uint16_t i = 0; i < DMA_BUF_SIZE; ++i){
    buf[i] =  lfo_next_value(&lfo);
  }
}

static float readADCChannel(uint32_t chselMask){
  // select only this channel so each start does exactly one conversion
  // (avoids an overrun when scanning both channels back to back)
  hadc.Instance->CHSELR = chselMask;
  if(HAL_ADC_Start(&hadc) != HAL_OK){
    Error_Handler();
  }
  if(HAL_ADC_PollForConversion(&hadc, 10) != HAL_OK){
    Error_Handler();
  }
  const uint32_t raw = HAL_ADC_GetValue(&hadc);
  HAL_ADC_Stop(&hadc);
  return (float)raw / 4095.0f;
}

void readPotADCs(){
  const float newSpeedValue = readADCChannel(ADC_CHSELR_CHSEL1);
  const float newShapeValue = readADCChannel(ADC_CHSELR_CHSEL2);
  // update if the value has changed by more than 3%
  if(!fwithin_error(currentSpeedValue, newSpeedValue, 0.03f)){
    currentSpeedValue = newSpeedValue;
    lfo_update_period(&lfo, 1.0f / norm_range_denormalize(&speedRange, currentSpeedValue));
    speedKnobMoved = true;
  }
  if(!fwithin_error(currentShapeValue, newShapeValue, 0.03f)){
    currentShapeValue = newShapeValue;
    lfo_update_peak_phase(&lfo, norm_range_denormalize(&shapeRange, currentShapeValue));
  }
}


void initControlRanges(){
  norm_range_init(&speedRange, SPEED_MIN, SPEED_MAX, SPEED_CENTER);
  norm_range_init(&shapeRange, SHAPE_MIN, SHAPE_MAX, SHAPE_CENTER);
}
/* USER CODE END 0 */

/**
  * @brief  The application entry point.
  * @retval int
  */
int main(void)
{

  /* MCU Configuration--------------------------------------------------------*/

  /* Reset of all peripherals, Initializes the Flash interface and the Systick. */
  HAL_Init();

  /* Configure the system clock */
  SystemClock_Config();

  /* Initialize all configured peripherals */
  MX_GPIO_Init();
  MX_DMA_Init();
  MX_DAC_Init();
  MX_ADC_Init();
  MX_TIM2_Init();
  MX_TIM6_Init();
  MX_TIM21_Init();
  /* USER CODE BEGIN 2 */
  // start the DMA stream for the DAC values
  if(HAL_DAC_Start_DMA(&hdac, DAC_CHANNEL_1, (uint32_t*)dmaBuf, DMA_BUF_SIZE * 2, DAC_ALIGN_12B_R)!= HAL_OK){
    Error_Handler();
  }
  // start the timer that triggers the DAC
  if(HAL_TIM_Base_Start(&htim2)!= HAL_OK){
    Error_Handler();
  }
  // start the timer for checking the buttons
  if(HAL_TIM_Base_Start_IT(&htim6)!= HAL_OK){
    Error_Handler();
  }
  // start the timer for checking the knobs
  if(HAL_TIM_Base_Start_IT(&htim21)!= HAL_OK){
    Error_Handler();
  }
  // initialize the LFO
  lfo_init_state(&lfo);
  // initialize the control ranges
  initControlRanges();
  //initialize the tap tempo
  tap_tempo_init();
  /* USER CODE END 2 */

  /* Infinite loop */
  /* USER CODE BEGIN WHILE */
  while (1)
  {
    if(bufferReady){
      fillNextBuffer(nextBuffer);
      bufferReady = false;
    }
    /* USER CODE END WHILE */

    /* USER CODE BEGIN 3 */
  }
  /* USER CODE END 3 */
}

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
/* USER CODE BEGIN 4 */
//=====================================================================================
// DAC callbacks------------------------------------------
void HAL_DAC_ConvHalfCpltCallbackCh1(DAC_HandleTypeDef * dac){
  nextBuffer = dmaPtrA;
  bufferReady = true;
}
void HAL_DAC_ConvCpltCallbackCh1(DAC_HandleTypeDef * dac){
  nextBuffer = dmaPtrB;
  bufferReady = true;
}

float get_global_time(){
  return globalSeconds;
}
// Timer callbacks----------------------------------------
void HAL_TIM_PeriodElapsedCallback(TIM_HandleTypeDef *htim){
  if(htim == &htim6){
    tap_tempo_update((bool)HAL_GPIO_ReadPin(TAP_IN_GPIO_Port, TAP_IN_Pin));
    globalSeconds += secsIncrement;
  } else if (htim == &htim21){
    readPotADCs();
    // if the speed control moved, don't bother checking on the tap tempo
    if(speedKnobMoved){
      inTapMode = false;
      speedKnobMoved = false;
    } else if (tap_tempo_was_tapped_within(0.01f)){
      inTapMode = true;
      lfo_update_period(&lfo, tap_tempo_current_period());
    }

  }
}
//=====================================================================================

/* USER CODE END 4 */
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
