hsetlik/PhaserPedal/PhaserPedalFirmware/Core/Inc/main.h

#define SAMPLE_RATE 48000
#define TAP_SAMPLE_RATE 8000
#define DMA_BUF_SIZE 256
#define SPEED_IN_Pin GPIO_PIN_1
#define SPEED_IN_GPIO_Port GPIOA
#define SHAPE_IN_Pin GPIO_PIN_2
#define SHAPE_IN_GPIO_Port GPIOA
#define BYP_LED_Pin GPIO_PIN_0
#define BYP_LED_GPIO_Port GPIOB
#define BYPASS_IN_Pin GPIO_PIN_8
#define BYPASS_IN_GPIO_Port GPIOA
#define TAP_IN_Pin GPIO_PIN_9
#define TAP_IN_GPIO_Port GPIOA
