hsetlik/PhaserPedal/(commit log)

2026-10-11 New circuit sim
2026-10-11 improved control current range
2026-10-12 DAC stage looks good in sim
2026-10-12 rough schematic
2026-10-12 schematic hygiene
